Athenachc/sav_gripper/(commit log)

2024-08-24 Moulds for soft gripper with an inextensible layer
2024-08-24 Moulds of soft gripper without inextensible layer
2025-05-12 Add images of soft fingers
